HotPixelChannel/Candy_8bit/README.md

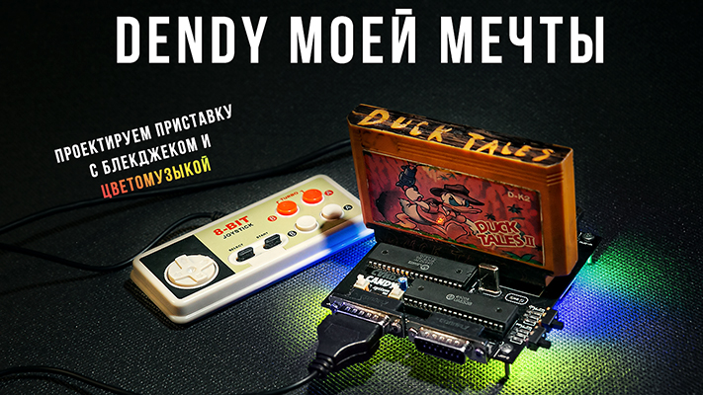
[picture p1: preview-small.jpg]
Иллюстрация к проекту

# Candy 8bit system
Проект клона Famicom (Dendy), основанный на схеме оригинальной Famicom и проекта Dendy Remake за авторством ***HardWareMan*** и ***megawalkman***.

* О проекте: https://youtu.be/0IENeqXopUg
* Обсуждендие проекта: https://www.emu-land.net/forum/index.php?topic=86361

Особенностью проекта является наличие цветомузыки, поддержка обычных 15 пиновых геймпадов, аксессуаров (пистолеты и т.д.) и "оригинальность" цифровой части схемы, а так же бюджетность изготовления платы 10х10 см. Для "аутентичности и ламповости" большинство SMD компонентов расположено либо на нижней стороне платы, либо под DIP микросхемами.

## ВНИМАНИЕ!
<span style="color:red">!!! Транзисторы Q3, Q4 лучше всего поставить BC856A или BC846B-TP, как оказалось, не на всех экземплярах чипов, указанные в схеме транзисторы, работают адекватно. При проблеме с цветом можно удалить подстроечные конденсаторы, а С11 и С14 заменить на 100нФ</span>.

### История изменений
v 1.1: 
* фикс видео усилителя
* переразводка аналоговых дорожек (от порта геймпада до картриджа все еще на своем старом месте)
* добавление дополнительных емкостей
