HotPixelChannel/Candy_8bit/Extras/Sch_Dendy_Remake.png

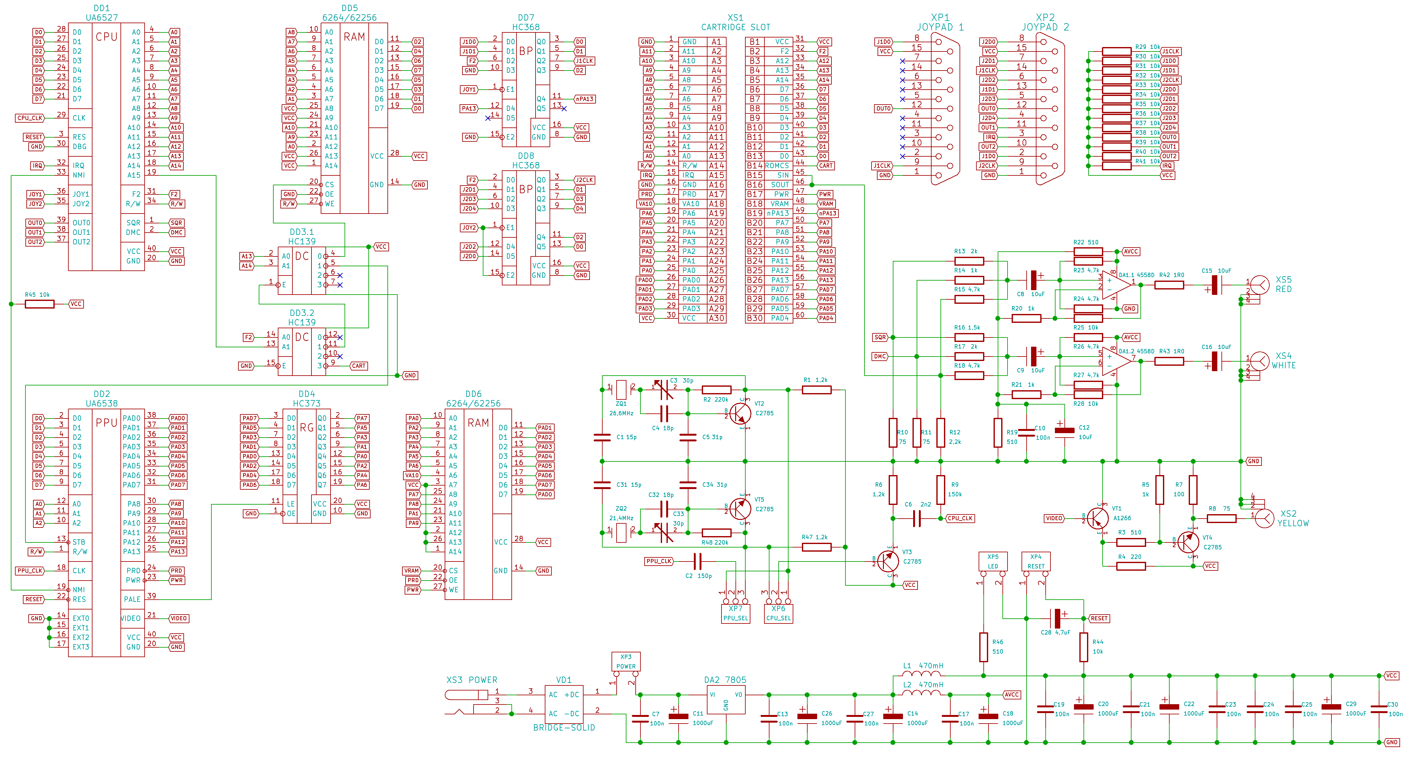
Extras/Sch_Dendy_Remake.png
