HotPixelChannel/Candy_8bit/Extras/Sch_Famicom_v2.jpg

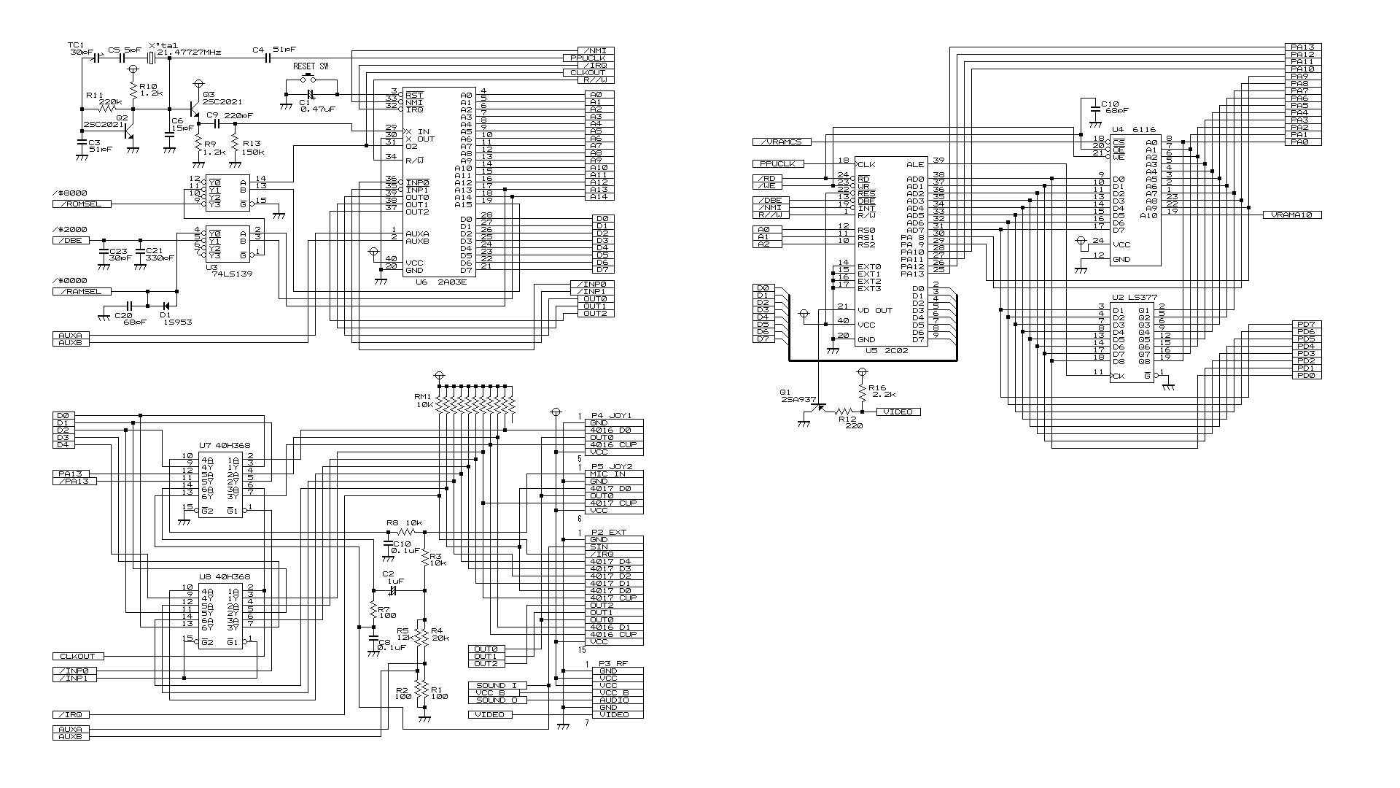
Extras/Sch_Famicom_v2.jpg
