HotPixelChannel/Candy_8bit/Extras/video_amp_fix.jpg

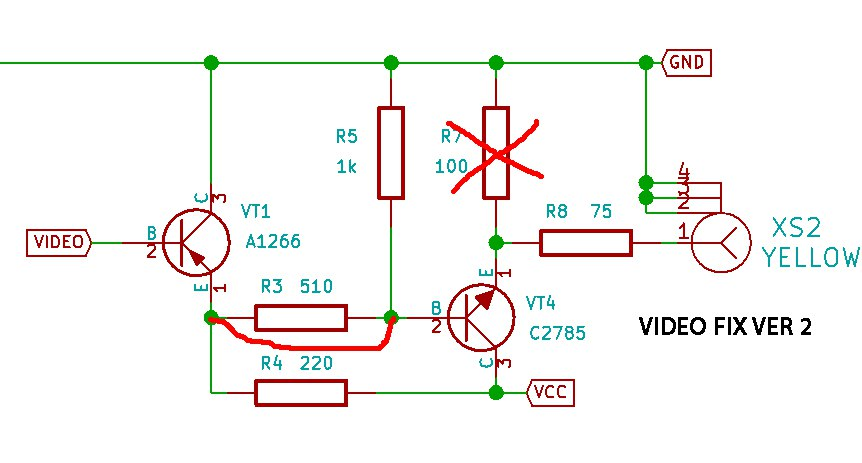
Extras/video_amp_fix.jpg
