HotPixelChannel/Candy_8bit/(threads)

Thread 1 (2021-12-04):

Can you upload the original design file of PCB? I want to change the packaging

ribenyamazun123, 2021-12-04:
Can you upload the original design file of PCB? I want to change the packaging

HotPixelChannel, 2021-12-07:
>

Done. But some custom models may be missing

Closed 2021-12-07.
