HotPixelChannel/Candy_8bit/Sch_Candy_8bit_system_v1.1.pdf

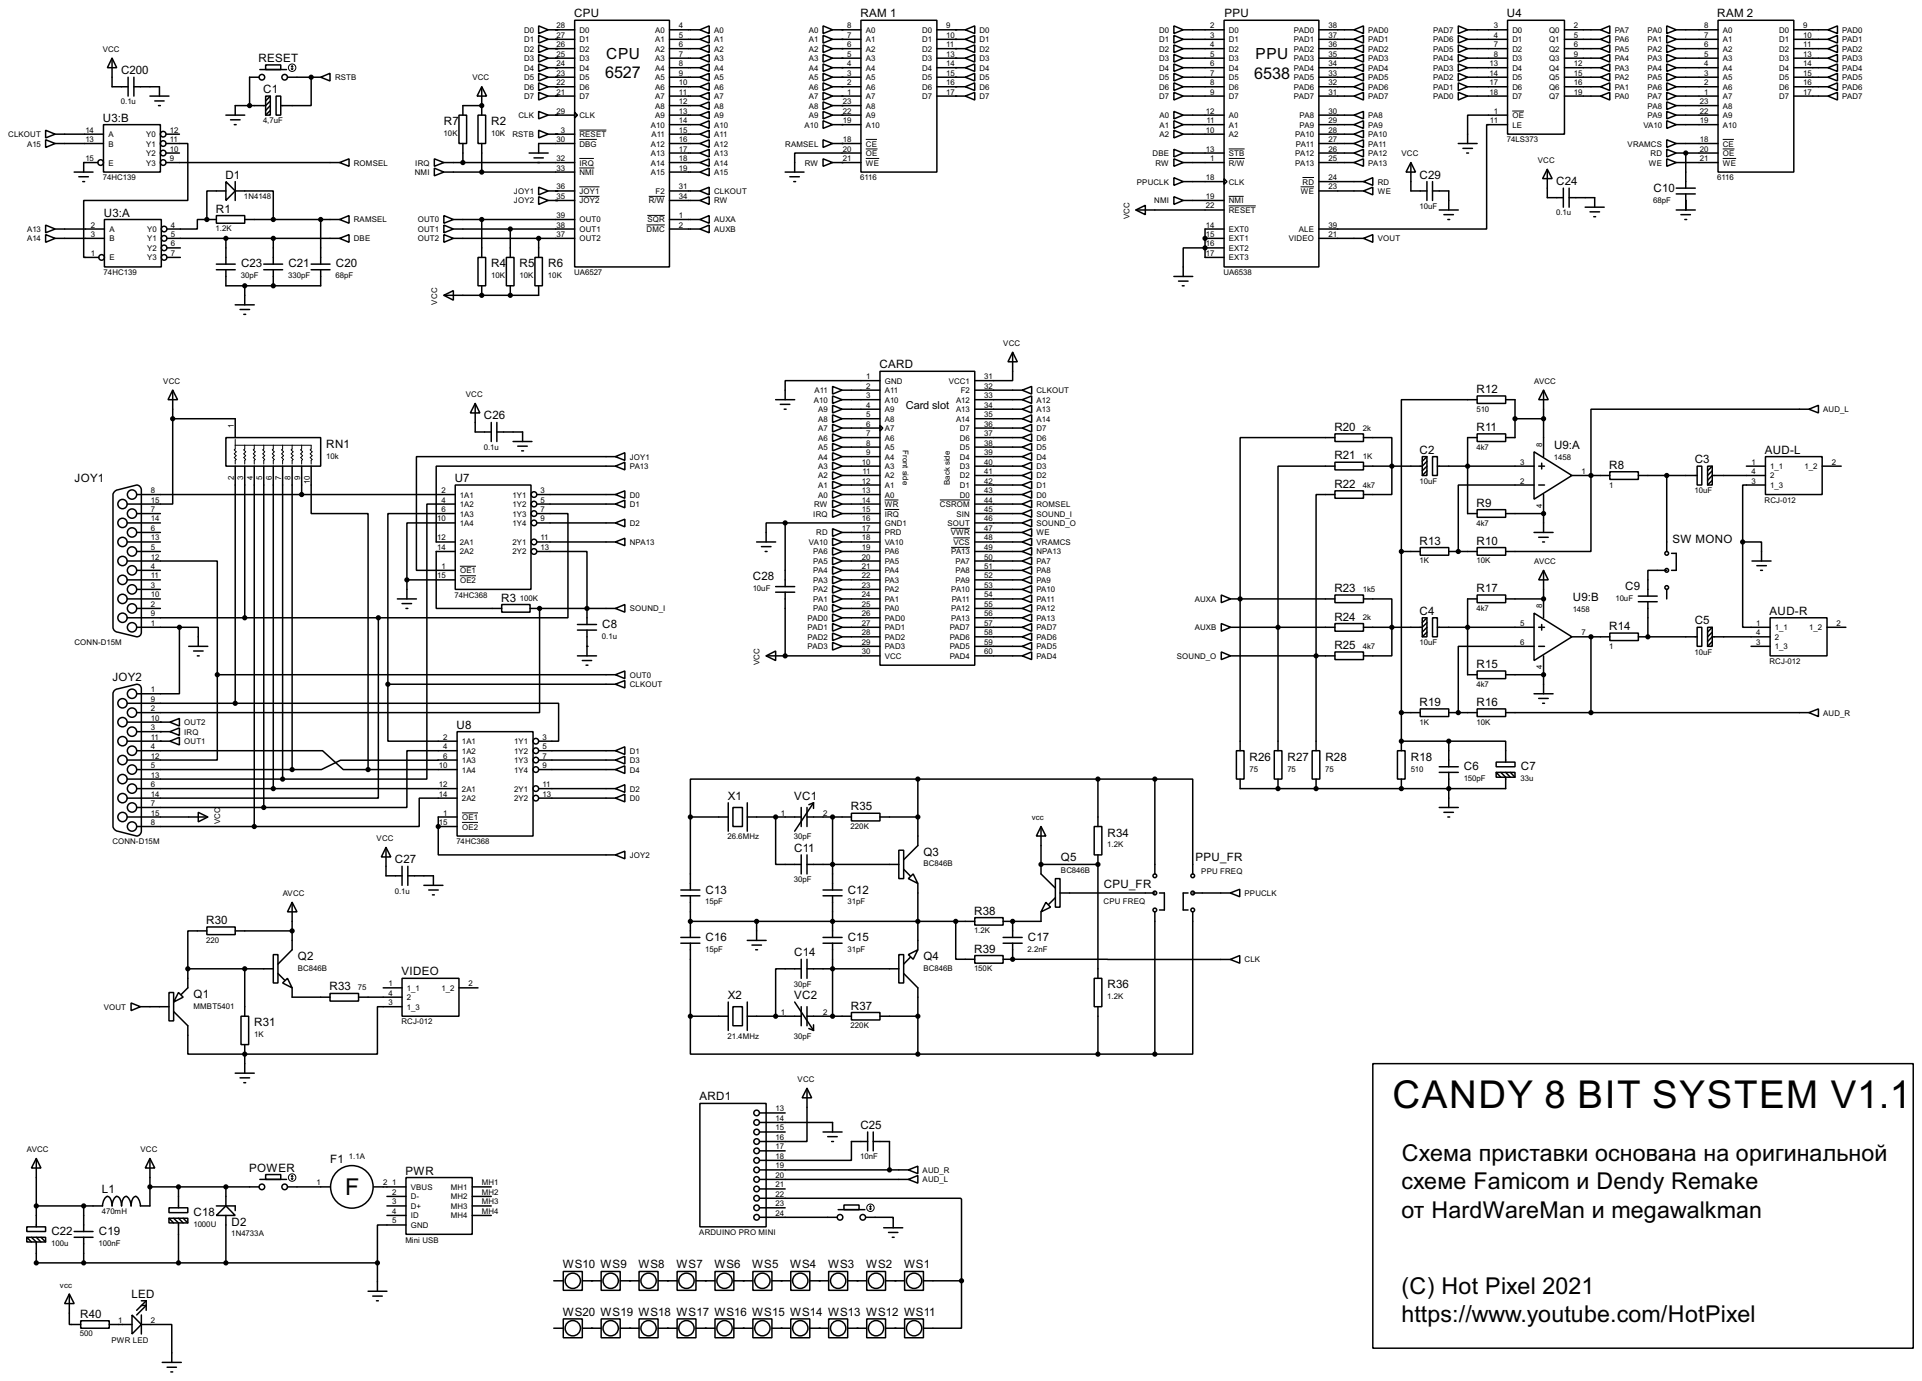
[picture p5: page 1]

4 | 1A2 1Y2 1A3 1Y3 1A4 1Y4 2A1 2Y1 2A2 2Y2 | 13 OE1

12
14

Схема приставки основана на оригинальной
схеме Famicom и Dendy Remake
от HardWareMan и megawalkman

(С) Hot Pixel 2021
https://www.youtube.com/HotPixel
